macnamtran/ProtectionGateDriver/images/layout-iteration-1-3d.png

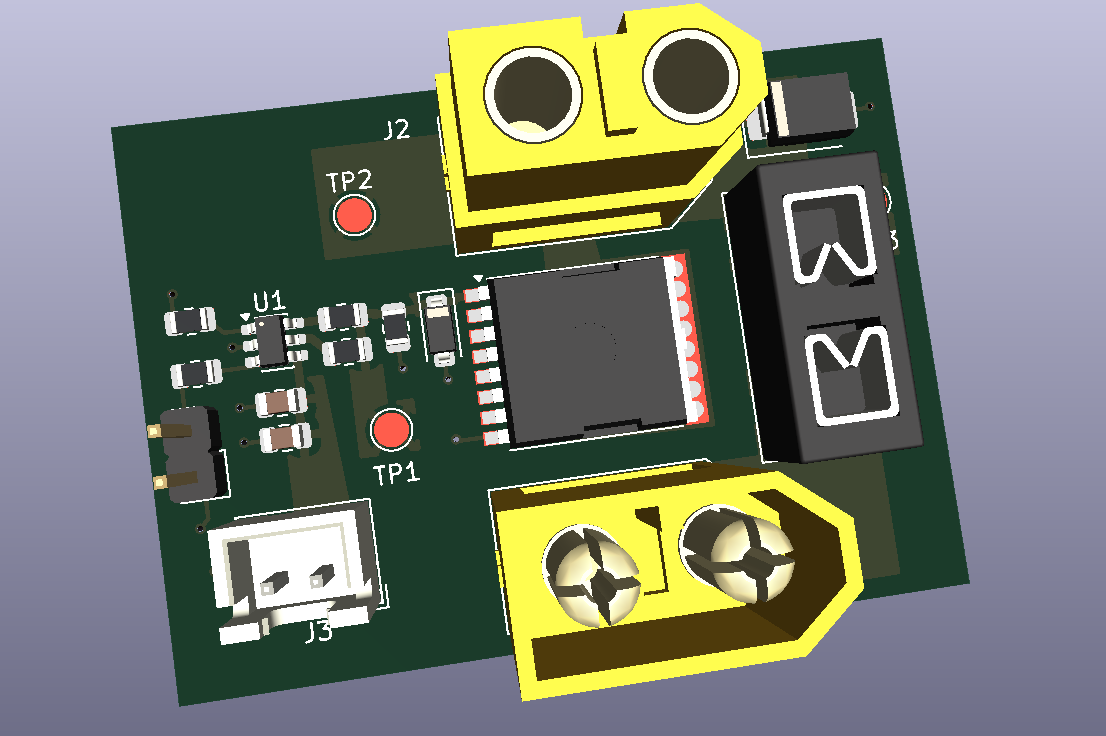
images/layout-iteration-1-3d.png
