macnamtran/ProtectionGateDriver/images/layout-iteration-1.png

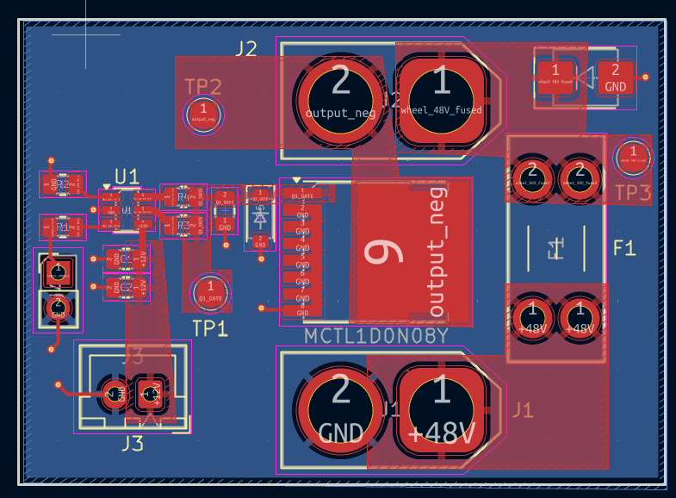
images/layout-iteration-1.png
