macnamtran/ProtectionGateDriver/ProtectionGateDriver.kicad_pcb

## KiCad design ProtectionGateDriver.kicad_pcb (2026-10-25)

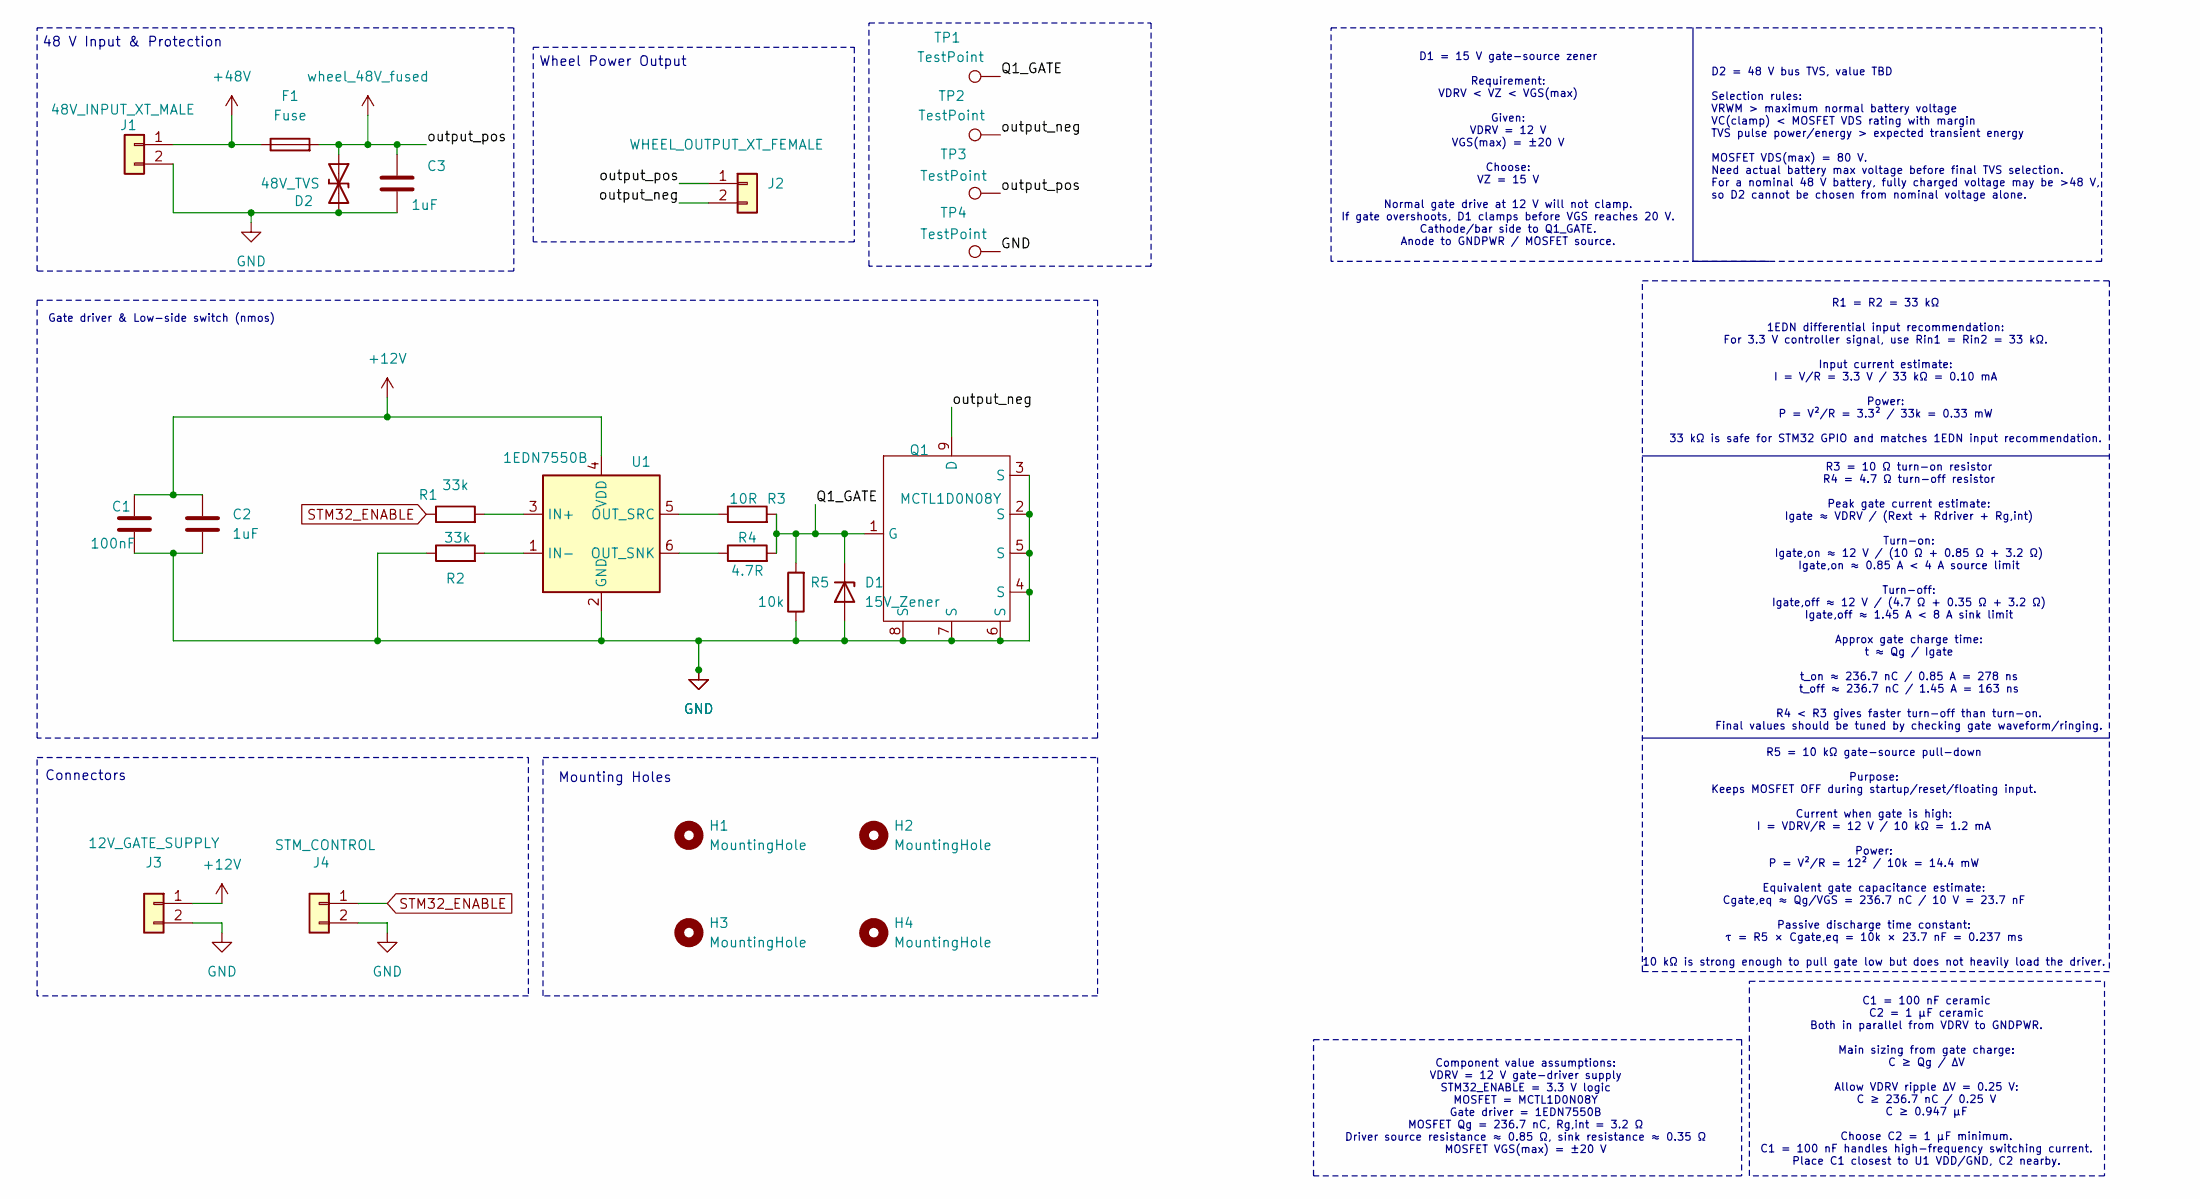
[picture p11: schematic ProtectionGateDriver.kicad_sch]

Parts:
C1: 100nF; C_0805_2012Metric
C2: 1uF; C_0805_2012Metric
C3: 1uF; C_Rect_L13.0mm_W8.0mm_P10.00mm_FKS3_FKP3_MKS4; MPN ECQ-E1105KF
D1: 15V_Zener; D_SOD-123
D2: 48V_TVS; D_SMB
F1: Fuse; Fuseholder_Blade_Mini_Keystone_3568
H1, H2, H3, H4: MountingHole; MountingHole_2.2mm_M2
J1: 48V_INPUT_XT_MALE; AMASS_XT60-M_1x02_P7.20mm_Vertical
J2: WHEEL_OUTPUT_XT_FEMALE; AMASS_XT60-F_1x02_P7.20mm_Vertical
J3: 12V_GATE_SUPPLY; JST_XH_B2B-XH-A_1x02_P2.50mm_Vertical
J4: STM_CONTROL; PinHeader_1x02_P2.54mm_Vertical
Q1: MCTL1D0N08Y; MCC_MCTL1D0N08Y_TOLL8L
R1, R2: 33k; R_0805_2012Metric
R3: 10R; R_0805_2012Metric
R4: 4.7R; R_0805_2012Metric
R5: 10k; R_0805_2012Metric
TP1, TP2, TP3, TP4: TestPoint; TestPoint_Pad_D1.0mm
U1: 1EDN7550B; SOT-23-6

Connections:
+12V: C1.1, C2.1, J3.1, U1.4 (VDD)
+48V: F1.1, J1.1
/Q1_GATE: D1.1 (K), Q1.1 (G), R3.2, R4.2, R5.2, TP1.1 (1_1)
/output_neg: J2.2, Q1.9 (D), TP2.1 (1_1)
GND: C1.2, C2.2, C3.2, D1.2 (A), D2.2 (A2), J1.2, J3.2, J4.2, Q1.2 (S), Q1.3 (S), Q1.4 (S), Q1.5 (S), Q1.6 (S), Q1.7 (S), Q1.8 (S), R2.1, R5.1, TP4.1 (1_1), U1.2 (GND)
unnamed: R1.2, U1.3 (IN+)
unnamed: R2.2, U1.1 (IN-)
unnamed: R4.1, U1.6 (OUT_SNK)
unnamed: R3.1, U1.5 (OUT_SRC)
STM32_ENABLE: J4.1, R1.1
wheel_48V_fused: C3.1, D2.1 (A1), F1.2, J2.1, TP3.1 (1_1)

Notes on the sheet:
R5 = 10 kΩ gate-source pull-down Purpose: Keeps MOSFET OFF during startup/reset/floating input. Current when gate is high: I = VDRV/R = 12 V / 10 kΩ = 1.2 mA Power: P = V²/R = 12² / 10k = 14.4 mW Equivalent gate capacitance estimate: Cgate,eq ≈ Qg/VGS = 236.7 nC / 10 V = 23.7 nF Passive discharge t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
D1 = 15 V gate-source zener Requirement: VDRV < VZ < VGS(max) Given: VDRV = 12 V VGS(max) = ±20 V Choose: VZ = 15 V Normal gate drive at 12 V will not clamp. If gate overshoots, D1 clamps before VGS reaches 20 V. Cathode/bar side to Q1_GATE. Anode to GNDPWR / MOSFET source.
48 V Input & Protection
Wheel Power Output
C1 = 100 nF ceramic C2 = 1 µF ceramic Both in parallel from VDRV to GNDPWR. Main sizing from gate charge: C ≥ Qg / ΔV Allow VDRV ripple ΔV = 0.25 V: C ≥ 236.7 nC / 0.25 V C ≥ 0.947 µF Choose C2 = 1 µF minimum. C1 = 100 nF handles high-frequency switching current. Place C1 closest to U1 VDD/GND, C2 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
D2 = 48 V bus TVS, value TBD Selection rules: VRWM > maximum normal battery voltage VC(clamp) < MOSFET VDS rating with margin TVS pulse power/energy > expected transient energy MOSFET VDS(max) = 80 V. Need actual battery max voltage before final TVS selection. For a nominal 48 V battery, fully char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
Connectors
R3 = 10 Ω turn-on resistor R4 = 4.7 Ω turn-off resistor Peak gate current estimate: Igate ≈ VDRV / (Rext + Rdriver + Rg,int) Turn-on: Igate,on ≈ 12 V / (10 Ω + 0.85 Ω + 3.2 Ω) Igate,on ≈ 0.85 A < 4 A source limit Turn-off: Igate,off ≈ 12 V / (4.7 Ω + 0.35 Ω + 3.2 Ω) Igate,off ≈ 1.45 A < 8 A sink li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
Gate driver & Low-side switch (nmos)
R1 = R2 = 33 kΩ 1EDN differential input recommendation: For 3.3 V controller signal, use Rin1 = Rin2 = 33 kΩ. Input current estimate: I = V/R = 3.3 V / 33 kΩ = 0.10 mA Power: P = V²/R = 3.3² / 33k = 0.33 mW 33 kΩ is safe for STM32 GPIO and matches 1EDN input recommendation.
Mounting Holes
Component value assumptions: VDRV = 12 V gate-driver supply STM32_ENABLE = 3.3 V logic MOSFET = MCTL1D0N08Y Gate driver = 1EDN7550B MOSFET Qg = 236.7 nC, Rg,int = 3.2 Ω Driver source resistance ≈ 0.85 Ω, sink resistance ≈ 0.35 Ω MOSFET VGS(max) = ±20 V

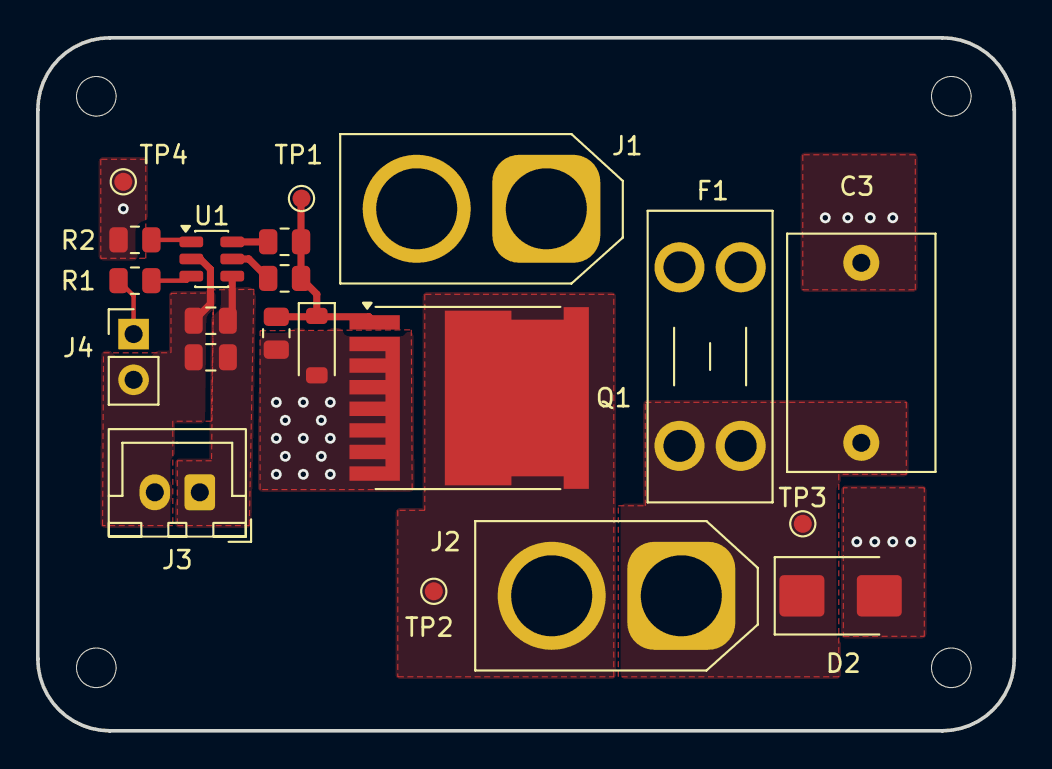
[picture p12: board ProtectionGateDriver.kicad_pcb from above]

Board: 4 copper layers, 54.2 x 38.5 mm, 25 parts (0 on the bottom side), 11 nets.
