macnamtran/ProtectionGateDriver/(commit log)

2026-09-17 Document wheel power switch design and outstanding review items
2026-09-17 Add KiCad schematic and portable project libraries
    [ProtectionGateDriver.kicad_sch]
2026-09-17 Show schematic and calculation screenshots with preliminary review notes
2026-09-27 Update schematic preview with reorganized one-wheel design
2026-10-01 docs: record schematic approval and next PCB layout stage
2026-10-01 Sync approved one-wheel schematic and portable KiCad project for layout
    [ProtectionGateDriver.kicad_sch]
2026-10-03 Save connector and footprint assignments with initial unrouted PCB
    [ProtectionGateDriver.kicad_pcb, ProtectionGateDriver.kicad_sch]
2026-10-09 Save first PCB layout iteration — not for fabrication
    Upload current KiCad layout and project settings, update schematic and layout previews, and document this as a preliminary review checkpoint. Not a final fabrication version; hardware validation remains outstanding.
    [ProtectionGateDriver.kicad_pcb]
2026-10-21 Save second PCB layout iteration — not for fabrication
    Update supplied KiCad board, project and schematic files; add layout and 3D previews. Document four-layer development checkpoint. Electrical review, ERC/DRC and hardware validation remain outstanding.
2026-10-21 Correct iteration 2 native KiCad files from uploaded project
    Replace stale PCB, project and schematic with the supplied iteration 2 files. Four-layer layout is a review checkpoint, not for fabrication.
    [ProtectionGateDriver.kicad_pcb, ProtectionGateDriver.kicad_sch]
2026-10-25 Save third protection-board layout iteration with native KiCad files
    Add input capacitor, M2 mounting holes, rounded outline and updated screenshots. Development checkpoint only; not for fabrication.
    [ProtectionGateDriver.kicad_pcb, ProtectionGateDriver.kicad_sch]
